mundodisco8/Snowflake/hardware/Snowflake.kicad_pcb

## KiCad design hardware/Snowflake.kicad_pcb (2023-11-08)

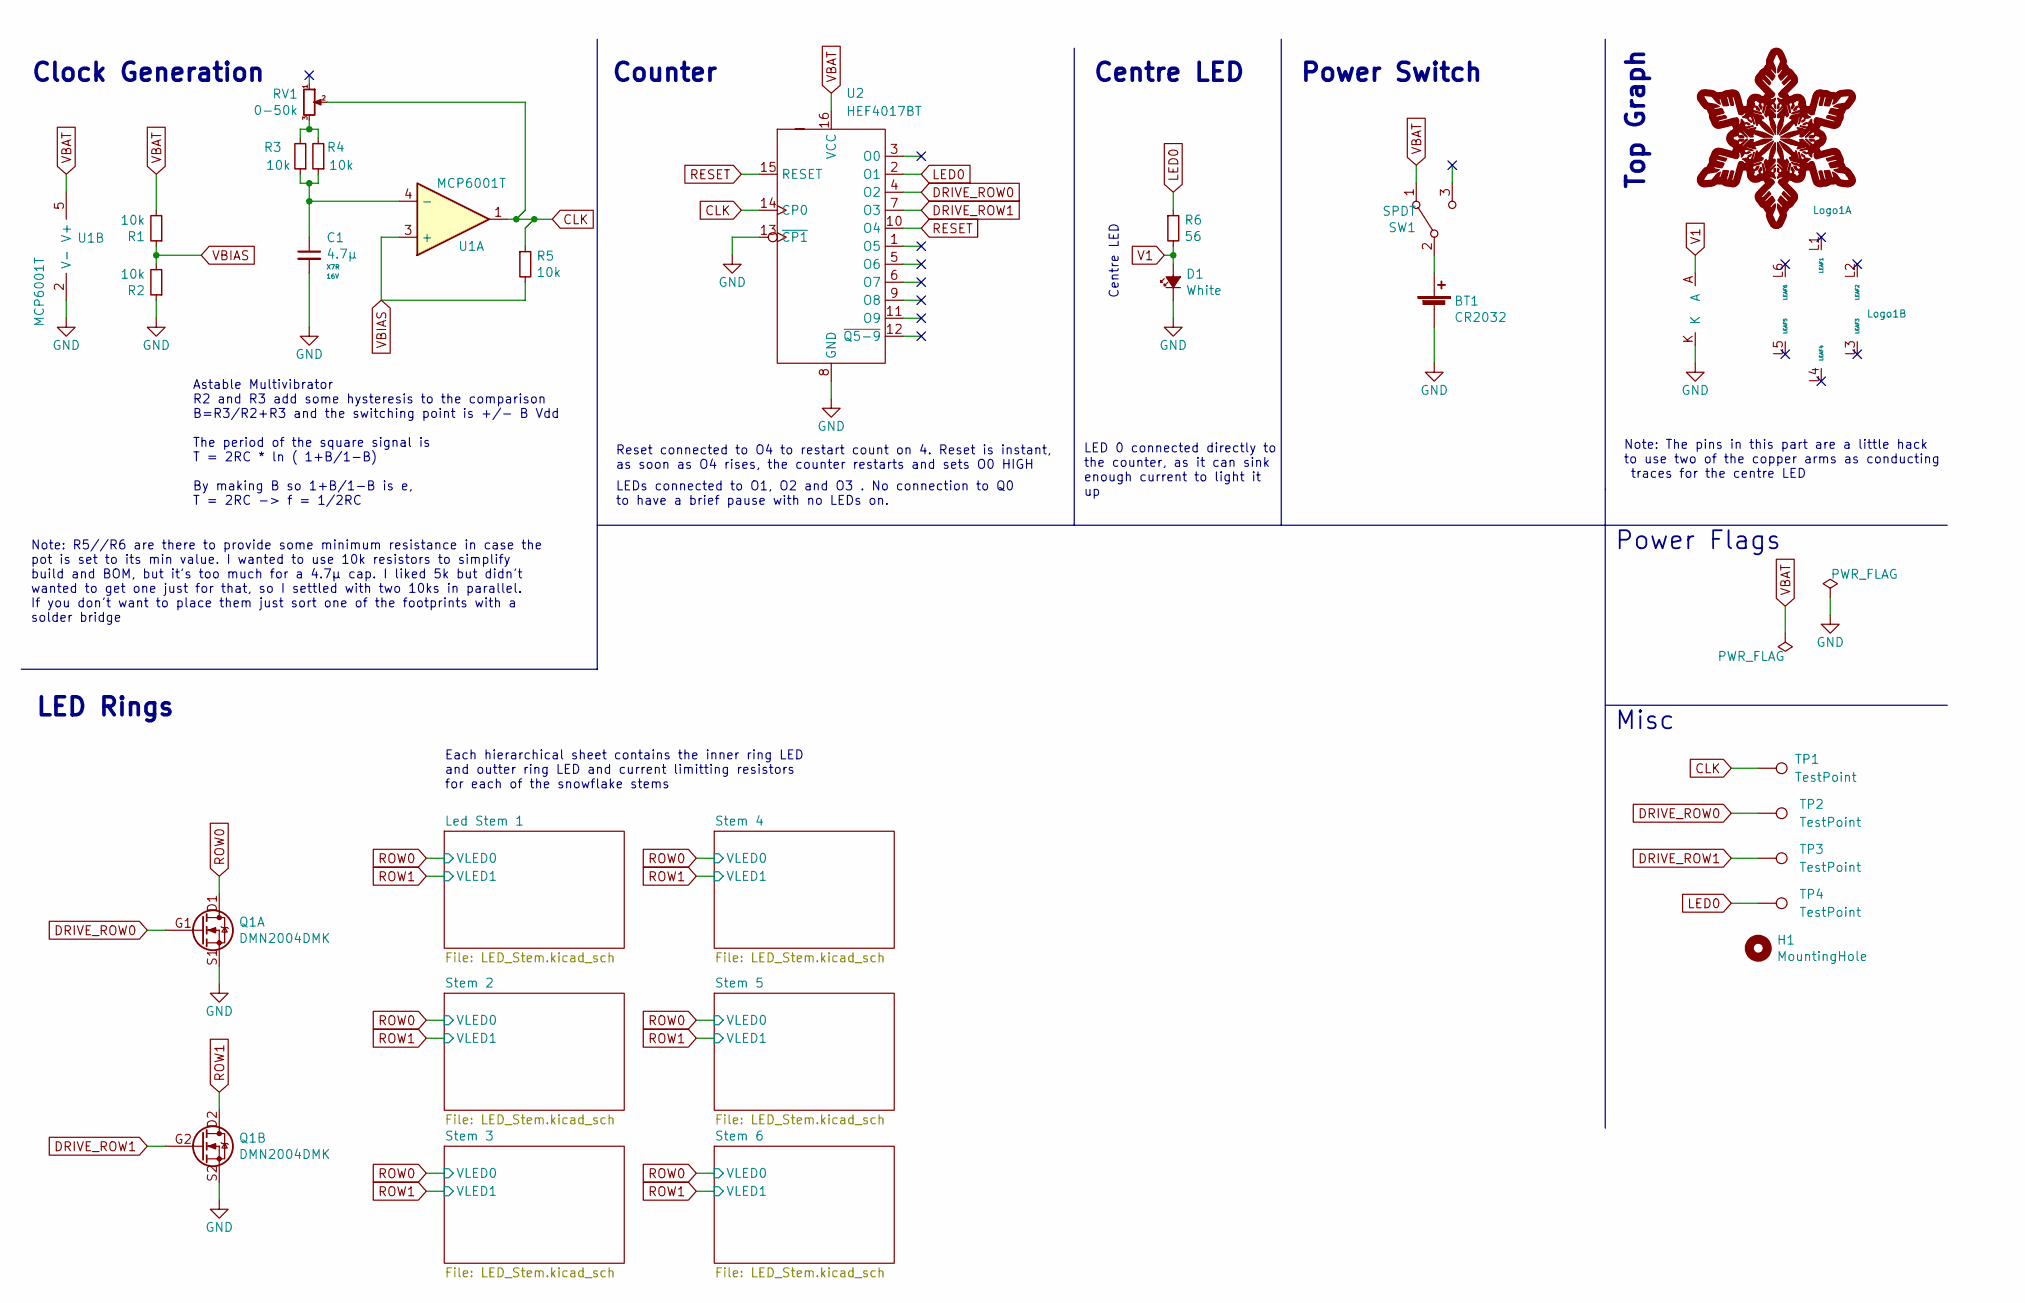
[picture p1: schematic Snowflake.kicad_sch]

Parts:
BT1: CR2032; CR2032_Keystone_3034; MPN 3034; Digikey PN 36-3034-ND
C1: 4.7μ; 0805-C_Handsolder_NoSilk; Tolerance ±10%; MPN GRM21BR71C475KE51K; Digikey PN 490-GRM21BR71C475KE51KCT-ND
D1: White; 3014_LED_HandSolder_NoSilk; MPN KWDCLMS2.EC-CXCZ-4L7M; Digikey PN 475-KWDCLMS2.EC-CXCZ-4L7M-1-20-R18CT-ND
H1: MountingHole; MountingHole_2.1mm_M2; MPN N/A; Digikey PN N/A
Logo1: Snowflake; MPN N/A; Digikey PN N/A
Q1: DMN2004DMK; SOT-23-6_DMN2004DMK_Handsoldering_NoSilk; MPN DMN2004DMK; Digikey PN DMN2004DMKDICT-ND
R1, R2, R3, R4, R5: 10k; 0805-R_Handsolder_NoSilk; Tolerance ±1%; MPN AF0805FR-0710KL; Digikey PN 13-AF0805FR-0710KLCT-ND
R6: 56; 0805-R_Handsolder_NoSilk; Tolerance ±1%; MPN RC0805FR-1056RL; Digikey PN 311-56ARCT-ND
RV1: 0-50k; Potentiometer_TC33X-2-204E_NoSilk; Tolerance ±25%; MPN TC33X-2-503E; Digikey PN TC33X-503ECT-ND
SW1: SPDT; Slider_Switch_C&K_AYZ0102AGRLC_SPDT_RightAngle_NoSilk; MPN AYZ0102AGRLC; Digikey PN 401-2012-1-ND
TP1, TP2, TP3, TP4: TestPoint; TestPoint_Pad_D1.0mm_NoSilk
U1: MCP6001T; Op_Amp_SOT23_MCP6001T_NoSilk; MPN MCP6001T-I/OT; Digikey PN MCP6001T-I/OTCT-ND
U2: HEF4017BT; 16-SOIC_3.9x9.9mm_P1.27mm_NoSilk; MPN HEF4017BT,653; Digikey PN 1727-6402-1-ND

Connections:
CLK: R5.1, RV1.2, TP1.1, U1.1, U2.14 (CP0)
DRIVE_ROW0: Q1.G1, TP2.1, U2.4 (O2)
DRIVE_ROW1: Q1.G2, TP3.1, U2.7 (O3)
GND: BT1.2 (-), C1.2, D1.K, Logo1.K, Q1.S1, Q1.S2 (S1), R2.1, U1.2 (V-), U2.8 (GND), U2.13 (~CP1)
LED0: R6.1, TP4.1, U2.2 (O1)
unnamed: BT1.1 (+), SW1.2 (B)
unnamed: R3.2, R4.2, RV1.3
unnamed: C1.1, R3.1, R4.1, U1.4 (-)
RESET: U2.10 (O4), U2.15 (RESET)
ROW0: Q1.D1; also elsewhere on the board
ROW1: Q1.D2 (D1); also elsewhere on the board
V1: D1.A, Logo1.A, R6.2
VBAT: R1.2, SW1.1 (A), U1.5 (V+), U2.16 (VCC); also elsewhere on the board
VBIAS: R1.1, R2.2, R5.2, U1.3 (+)

Notes on the sheet:
Top Graph
Clock Generation
Power Flags
Misc
Counter
Power Switch
Centre LED
Note: The pins in this part are a little hack to use two of the copper arms as conducting traces for the centre LED
Reset connected to O4 to restart count on 4. Reset is instant, as soon as O4 rises, the counter restarts and sets O0 HIGH
Each hierarchical sheet contains the inner ring LED and outter ring LED and current limitting resistors for each of the snowflake stems
LED Rings
Astable Multivibrator R2 and R3 add some hysteresis to the comparison B=R3/R2+R3 and the switching point is +/- B Vdd The period of the square signal is T = 2RC * ln ( 1+B/1-B) By making B so 1+B/1-B is e, T = 2RC -> f = 1/2RC
Centre LED
LEDs connected to O1, O2 and O3 . No connection to Q0 to have a brief pause with no LEDs on.
Note: R5//R6 are there to provide some minimum resistance in case the pot is set to its min value. I wanted to use 10k resistors to simplify build and BOM, but it's too much for a 4.7μ cap. I liked 5k but didn't wanted to get one just for that, so I settled with two 10ks in parallel. If you don't w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
LED 0 connected directly to the counter, as it can sink enough current to light it up

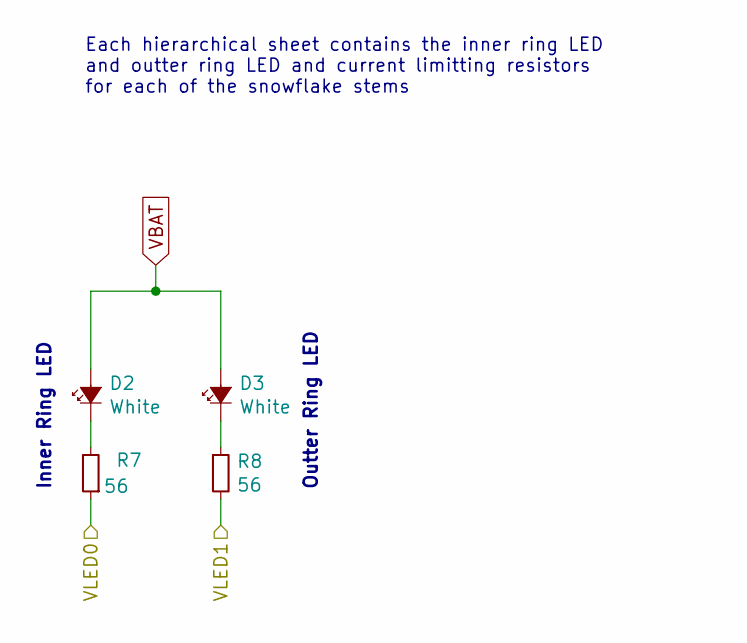
[picture p2: schematic LED_Stem.kicad_sch, Snowflake]

Parts:
D2, D3: White; 3014_LED_HandSolder_NoSilk; MPN KWDCLMS2.EC-CXCZ-4L7M; Digikey PN 475-KWDCLMS2.EC-CXCZ-4L7M-1-20-R18CT-ND
R7, R8: 56; 0805-R_Handsolder_NoSilk; Tolerance ±1%; MPN RC0805FR-1056RL; Digikey PN 311-56ARCT-ND

Connections:
unnamed: D2.K, R7.2
unnamed: D3.K, R8.1
ROW0: R7.1; also elsewhere on the board
ROW1: R8.2; also elsewhere on the board
VBAT: D2.A, D3.A; also elsewhere on the board

Parts of its further copies:
D4, D5, D6, D7, D8, D9, D10, D11, D12, D13: White; 3014_LED_HandSolder_NoSilk; MPN KWDCLMS2.EC-CXCZ-4L7M; Digikey PN 475-KWDCLMS2.EC-CXCZ-4L7M-1-20-R18CT-ND
R9, R10, R11, R12, R13, R14, R15, R16, R17, R18: 56; 0805-R_Handsolder_NoSilk; Tolerance ±1%; MPN RC0805FR-1056RL; Digikey PN 311-56ARCT-ND

Connections of its further copies:
unnamed: D4.K, R9.2
unnamed: D5.K, R10.1
unnamed: D6.K, R11.2
unnamed: D7.K, R12.1
unnamed: D8.K, R13.2
unnamed: D9.K, R14.1
unnamed: D10.K, R15.2
unnamed: D11.K, R16.1
unnamed: D12.K, R17.2
unnamed: D13.K, R18.1
ROW0: R9.1, R11.1, R13.1, R15.1, R17.1; also elsewhere on the board
ROW1: R10.2, R12.2, R14.2, R16.2, R18.2; also elsewhere on the board
VBAT: D4.A, D5.A, D6.A, D7.A, D8.A, D9.A, D10.A, D11.A, D12.A, D13.A; also elsewhere on the board

Notes on the sheet:
Outter Ring LED
Inner Ring LED
Each hierarchical sheet contains the inner ring LED and outter ring LED and current limitting resistors for each of the snowflake stems

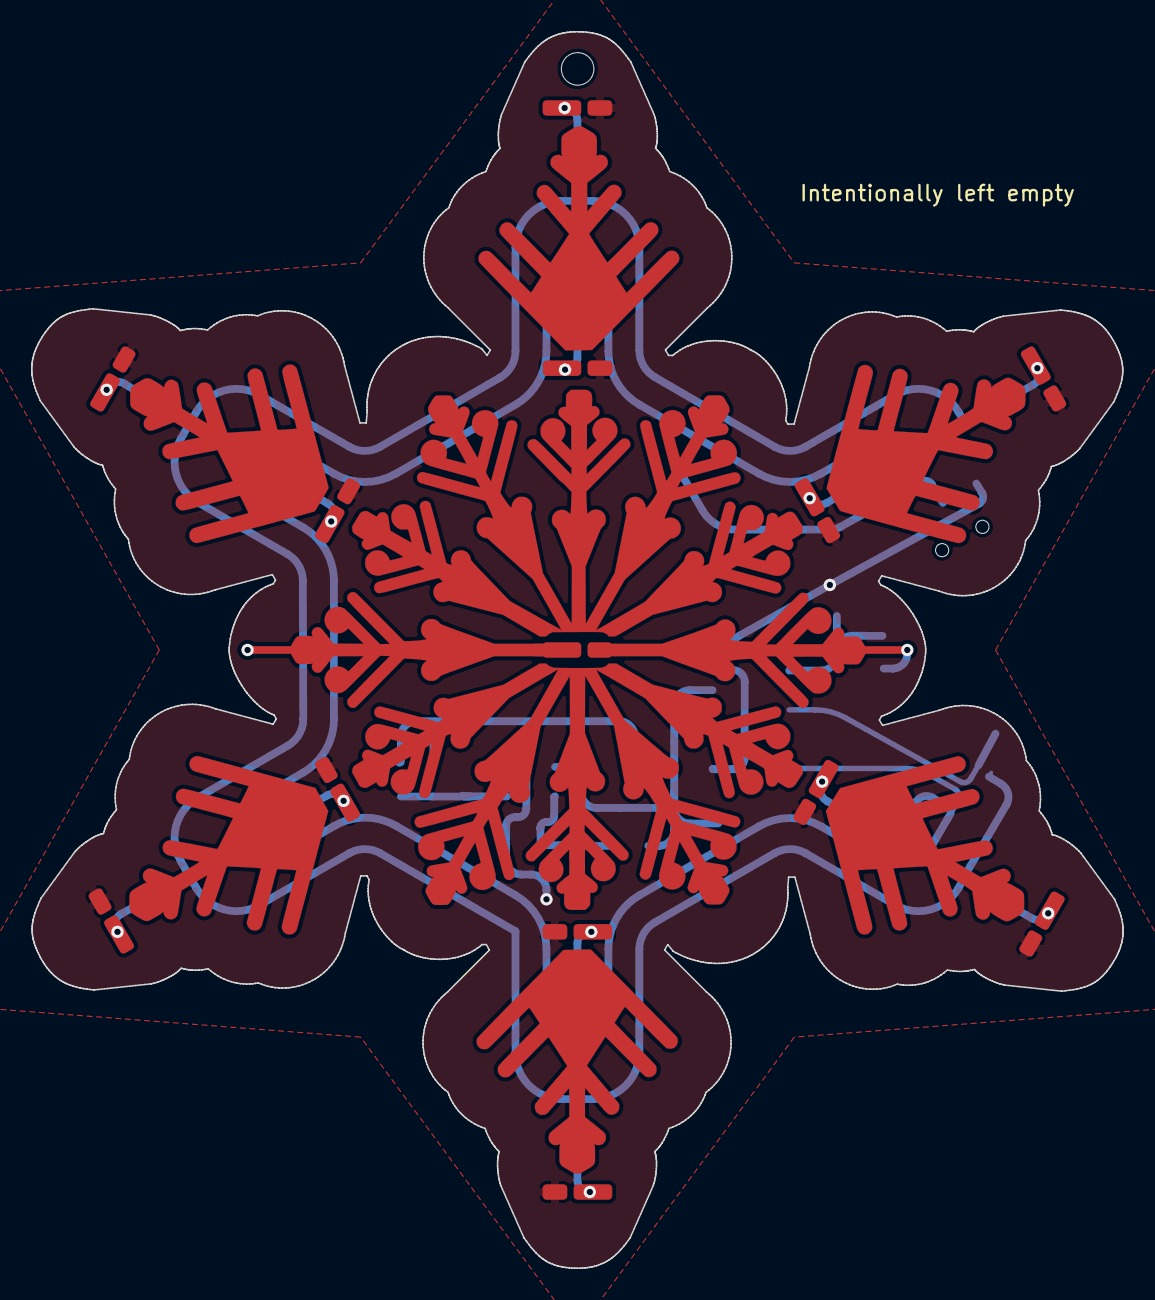
[picture p3: board Snowflake.kicad_pcb from above]

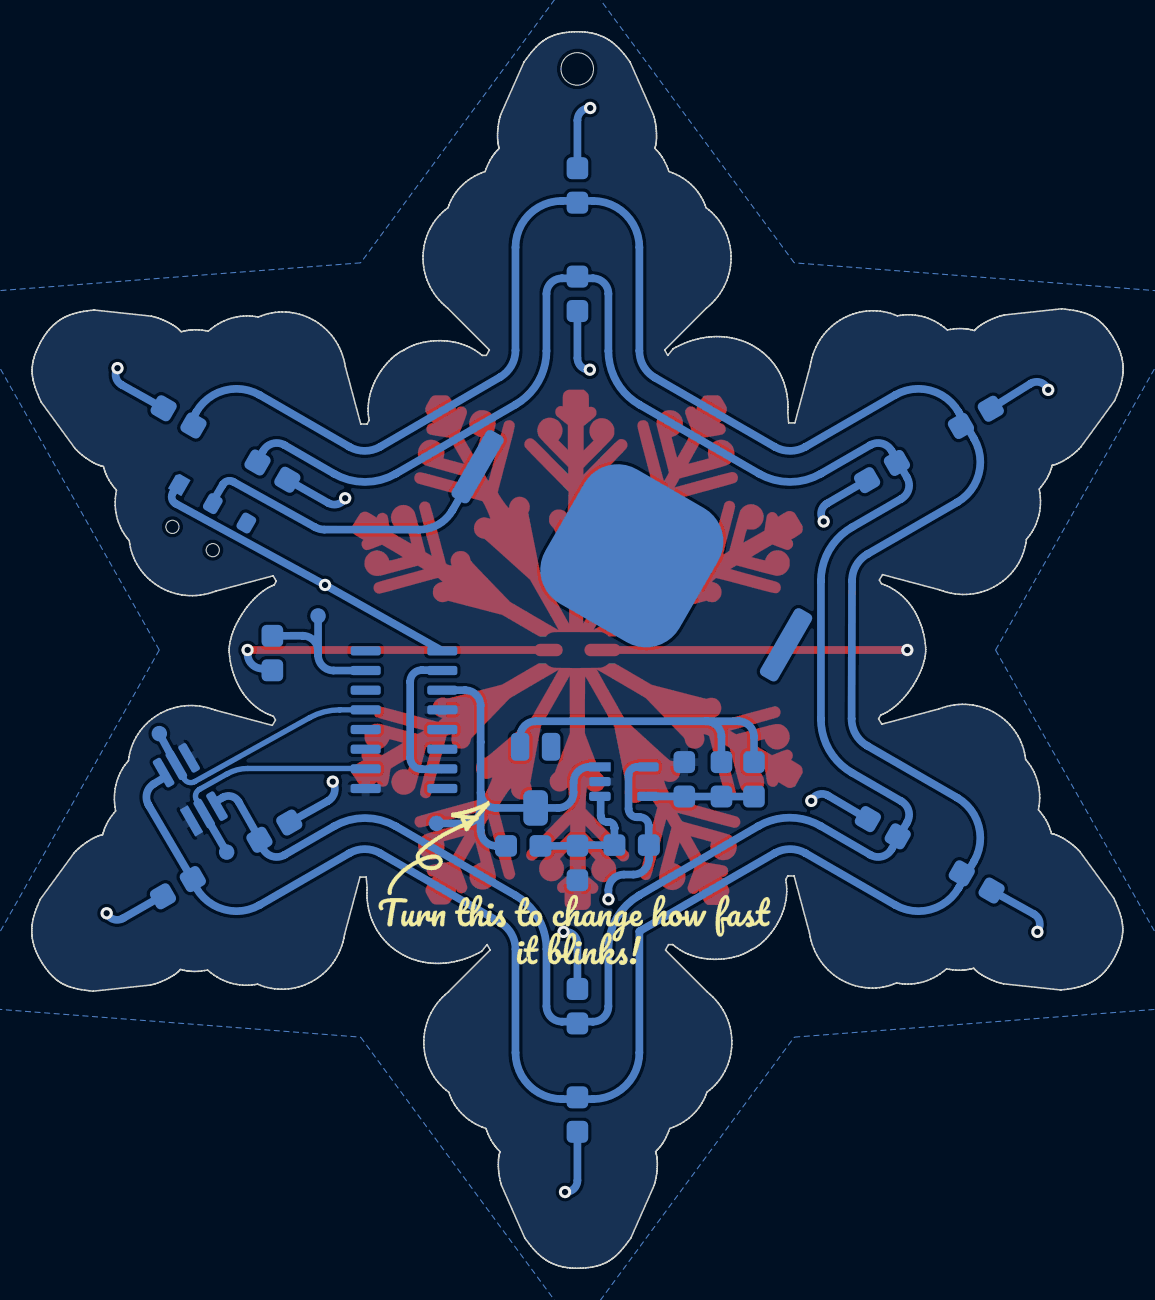
[picture p4: board Snowflake.kicad_pcb from below]

Board: 2 copper layers, 70.5 x 79.8 mm, 45 parts (30 on the bottom side), 26 nets.

Other parts of the board:
S1: Turn_This!
